Bekir111/access_control_hardware/README.md

# Access Control Hardware 

This repository contains the KiCad schematics and PCB designs for the Access Control System.
