Bekir111/access_control_hardware/access_control.kicad_pcb

## KiCad design access_control.kicad_pcb (2026-07-22)

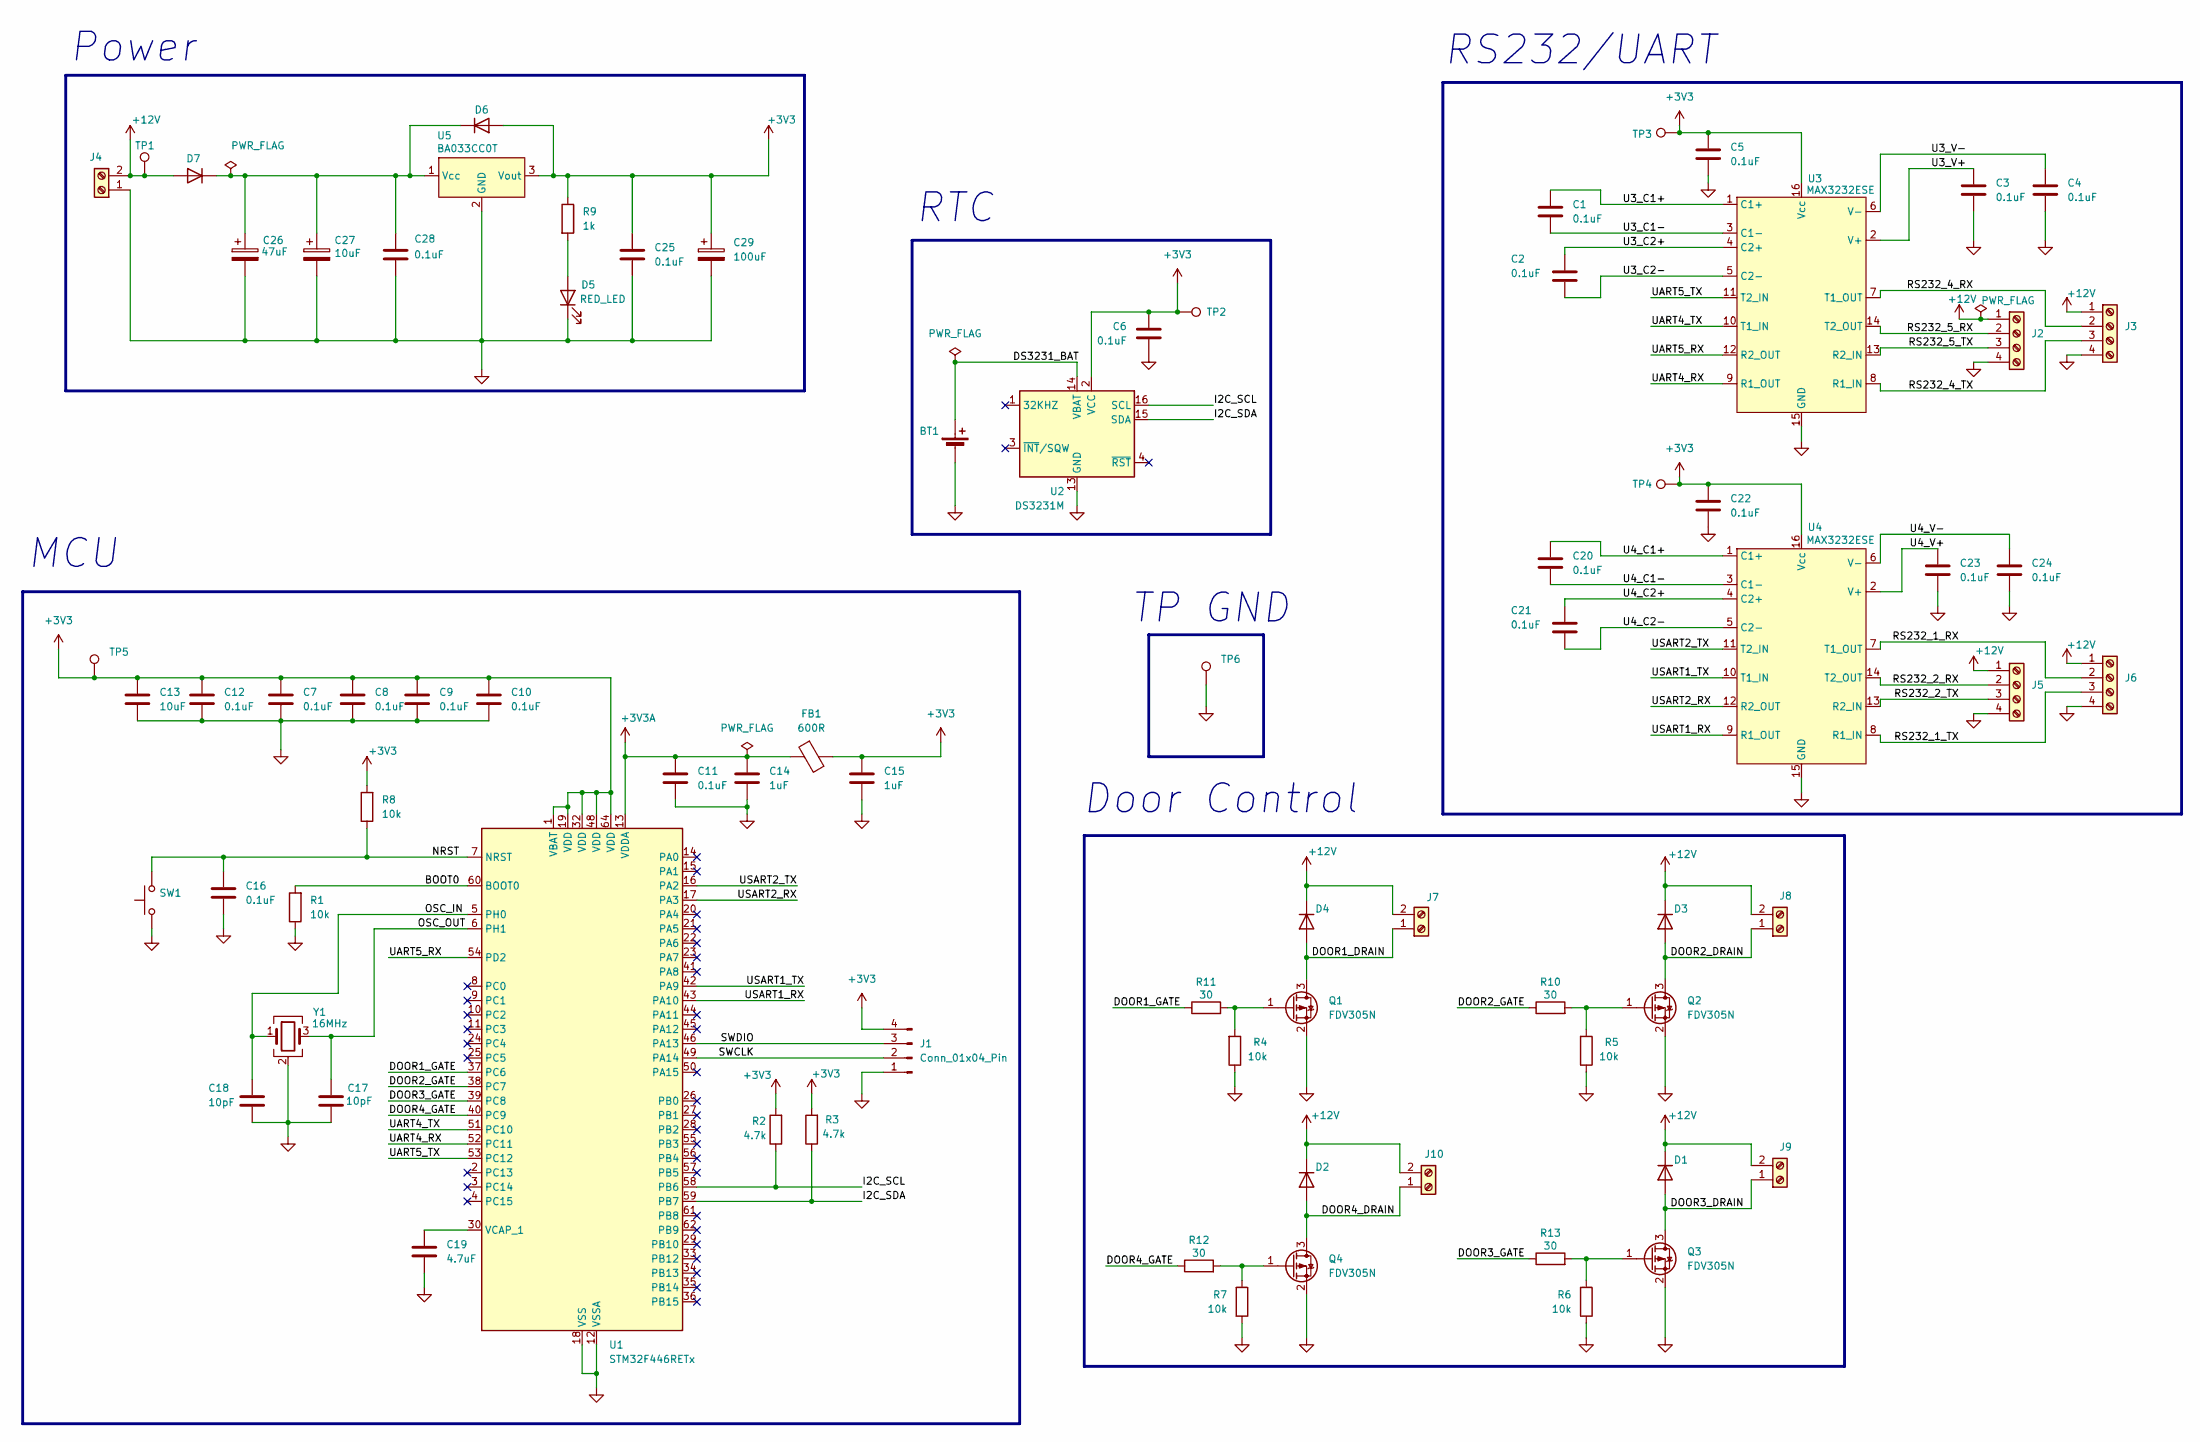
[picture p1: schematic access_control.kicad_sch]

Parts:
BT1: Battery_Cell; BatteryHolder_Keystone_1060_1x2032; LCSC C70377
C1, C2, C3, C4, C5, C6, C7, C8, C9, C10, C11, C12, C16, C20, C21, C22, C23, C24, C25, C28: 0.1uF; C_0805_2012Metric_Pad1.18x1.45mm_HandSolder; LCSC C1711
C13: 10uF; C_0805_2012Metric_Pad1.18x1.45mm_HandSolder; LCSC C15850
C14, C15: 1uF; C_0805_2012Metric_Pad1.18x1.45mm_HandSolder; LCSC C91185
C17, C18: 10pF; C_0805_2012Metric_Pad1.18x1.45mm_HandSolder; MPN CC0805JRNPO9BN100; LCSC C107107
C19: 4.7uF; C_0805_2012Metric_Pad1.18x1.45mm_HandSolder; MPN CL21A475KAQNNNE
C26: 47uF; CP_Radial_D6.3mm_P2.50mm; MPN EXR470M35B
C27: 10uF; CP_Radial_D5.0mm_P2.50mm; MPN RK1V100M-TSD11
C29: 100uF; CP_Radial_D6.3mm_P2.50mm; MPN RM1C101M-RBE07
D1, D2, D3, D4, D6, D7: D; D_SMA-SMB_Universal_Handsoldering; MPN M7; LCSC C2972759
D5: RED_LED; LED_D3.0mm
FB1: 600R; L_0805_2012Metric_Pad1.05x1.20mm_HandSolder; MPN BLM21BD601SN1D; LCSC C341663
J1: Conn_01x04_Pin; PinHeader_1x04_P2.54mm_Vertical
J2, J3, J5, J6: Screw_Terminal_01x04; TerminalBlock_Phoenix_MKDS-1,5-4-5.08_1x04_P5.08mm_Horizont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
J4, J7, J8, J9, J10: Screw_Terminal_01x02; TerminalBlock_Phoenix_MKDS-1,5-2-5.08_1x02_P5.08mm_Horizont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
Q1, Q2, Q3, Q4: FDV305N; SOT-23; MPN FDV305N; LCSC C154511
R1, R4, R5, R6, R7, R8: 10k; R_0805_2012Metric_Pad1.20x1.40mm_HandSolder; MPN RC0805FR-0710KL; LCSC C84376
R2, R3: 4.7k; R_0805_2012Metric_Pad1.20x1.40mm_HandSolder; MPN CRCW08054K70JNTABC; LCSC C2907326
R9: 1k; R_0805_2012Metric_Pad1.20x1.40mm_HandSolder; MPN RC0805FR-071KL; LCSC C2907295
R10, R11, R12, R13: 30; R_0805_2012Metric_Pad1.20x1.40mm_HandSolder; MPN CRCW080530R0FKTABC; LCSC C2907256
SW1: Reset button; SW_SPST_PTS645Sx43SMTR92; MPN TS110416043; LCSC C22375342
TP1, TP2, TP3, TP4, TP5, TP6: TestPoint; TestPoint_Pad_D2.0mm
U1: STM32F446RETx; LQFP-64_10x10mm_P0.5mm; MPN STM32F446RET6; LCSC C69336
U2: DS3231M; SOIC-16W_7.5x10.3mm_P1.27mm; MPN DS3231SN#T&R; LCSC C9866
U3, U4: MAX3232ESE; SOIC-16_3.9x9.9mm_P1.27mm; LCSC C143435
U5: BA033CC0T; TO-220-3_Horizontal_TabDown; MPN BA033CC0T; LCSC C184572
Y1: 16MHz; Crystal_SMD_3225-4Pin_3.2x2.5mm_HandSoldering; MPN X322516MKB4SI; LCSC C13738

Connections:
+3V3: C5.1, C6.1, C7.1, C8.1, C9.1, C10.1, C12.1, C13.1, C15.1, C22.1, C25.1, C29.1, D6.2 (A), FB1.2, J1.4, R2.2, R3.2, R8.2, R9.1, TP2.1, TP3.1, TP4.1, TP5.1, U1.1 (VBAT), U1.19 (VDD), U1.32 (VDD), U1.48 (VDD), U1.64 (VDD), U2.2 (VCC), U3.16 (Vcc), U4.16 (Vcc), U5.3 (Vout)
+3V3A: C11.1, C14.1, FB1.1, U1.13 (VDDA)
+12V: D1.1 (K), D2.1 (K), D3.1 (K), D4.1 (K), D7.2 (A), J2.1, J3.1, J4.2, J5.1, J6.1, J7.2, J8.2, J9.2, J10.2, TP1.1
/BOOT0: R1.2, U1.60 (BOOT0)
/DOOR1_DRAIN: D4.2 (A), J7.1, Q1.3 (D)
/DOOR1_GATE: R11.1, U1.37 (PC6)
/DOOR2_DRAIN: D3.2 (A), J8.1, Q2.3 (D)
/DOOR2_GATE: R10.1, U1.38 (PC7)
/DOOR3_DRAIN: D1.2 (A), J9.1, Q3.3 (D)
/DOOR3_GATE: R13.1, U1.39 (PC8)
/DOOR4_DRAIN: D2.2 (A), J10.1, Q4.3 (D)
/DOOR4_GATE: R12.1, U1.40 (PC9)
/DS3231_BAT: BT1.1 (+), U2.14 (VBAT)
/I2C_SCL: R2.1, U1.58 (PB6), U2.16 (SCL)
/I2C_SDA: R3.1, U1.59 (PB7), U2.15 (SDA)
/NRST: C16.1, R8.1, SW1.2, U1.7 (NRST)
/OSC_IN: C18.1, U1.5 (PH0), Y1.1
/OSC_OUT: C17.1, U1.6 (PH1), Y1.3
/RS232_1_RX: J6.2, U4.7 (T1_OUT)
/RS232_1_TX: J6.3, U4.8 (R1_IN)
/RS232_2_RX: J5.2, U4.14 (T2_OUT)
/RS232_2_TX: J5.3, U4.13 (R2_IN)
/RS232_4_RX: J3.2, U3.7 (T1_OUT)
/RS232_4_TX: J3.3, U3.8 (R1_IN)
/RS232_5_RX: J2.2, U3.14 (T2_OUT)
/RS232_5_TX: J2.3, U3.13 (R2_IN)
/SWCLK: J1.2, U1.49 (PA14)
/SWDIO: J1.3, U1.46 (PA13)
/U3_C1+: C1.1, U3.1 (C1+)
/U3_C1-: C1.2, U3.3 (C1-)
/U3_C2+: C2.1, U3.4 (C2+)
/U3_C2-: C2.2, U3.5 (C2-)
/U3_V+: C3.1, U3.2 (V+)
/U3_V-: C4.1, U3.6 (V-)
/U4_C1+: C20.1, U4.1 (C1+)
/U4_C1-: C20.2, U4.3 (C1-)
/U4_C2+: C21.1, U4.4 (C2+)
/U4_C2-: C21.2, U4.5 (C2-)
/U4_V+: C23.1, U4.2 (V+)
/U4_V-: C24.1, U4.6 (V-)
/UART4_RX: U1.52 (PC11), U3.9 (R1_OUT)
/UART4_TX: U1.51 (PC10), U3.10 (T1_IN)
/UART5_RX: U1.54 (PD2), U3.12 (R2_OUT)
/UART5_TX: U1.53 (PC12), U3.11 (T2_IN)
/USART1_RX: U1.43 (PA10), U4.9 (R1_OUT)
/USART1_TX: U1.42 (PA9), U4.10 (T1_IN)
/USART2_RX: U1.17 (PA3), U4.12 (R2_OUT)
/USART2_TX: U1.16 (PA2), U4.11 (T2_IN)
GND: BT1.2 (-), C3.2, C4.2, C5.2, C6.2, C7.2, C8.2, C9.2, C10.2, C11.2, C12.2, C13.2, C14.2, C15.2, C16.2, C17.2, C18.2, C19.2, C22.2, C23.2, C24.2, C25.2, C26.2, C27.2, C28.2, C29.2, D5.1 (K), J1.1, J2.4, J3.4, J4.1, J5.4, J6.4, Q1.2 (S), Q2.2 (S), Q3.2 (S), Q4.2 (S), R1.1, R4.1, R5.1, R6.1, R7.1, SW1.1, TP6.1, U1.12 (VSSA), U1.18 (VSS), U1.31 (VSS), U1.47 (VSS), U1.63 (VSS), U2.5 (GND), U2.6 (GND), U2.7 (GND), U2.8 (GND), U2.9 (GND), U2.10 (GND), U2.11 (GND), U2.12 (GND), U2.13 (GND), U3.15 (GND), U4.15 (GND), U5.2 (GND), Y1.2 (G), Y1.4 (G)
unnamed: D5.2 (A), R9.2
unnamed: C26.1, C27.1, C28.1, D6.1 (K), D7.1 (K), U5.1 (Vcc)
unnamed: Q1.1 (G), R4.2, R11.2
unnamed: Q2.1 (G), R5.2, R10.2
unnamed: Q3.1 (G), R6.2, R13.2
unnamed: Q4.1 (G), R7.2, R12.2
unnamed: C19.1, U1.30 (VCAP_1)

Notes on the sheet:
Door Control
TP GND
RS232/UART
MCU
RTC
Power

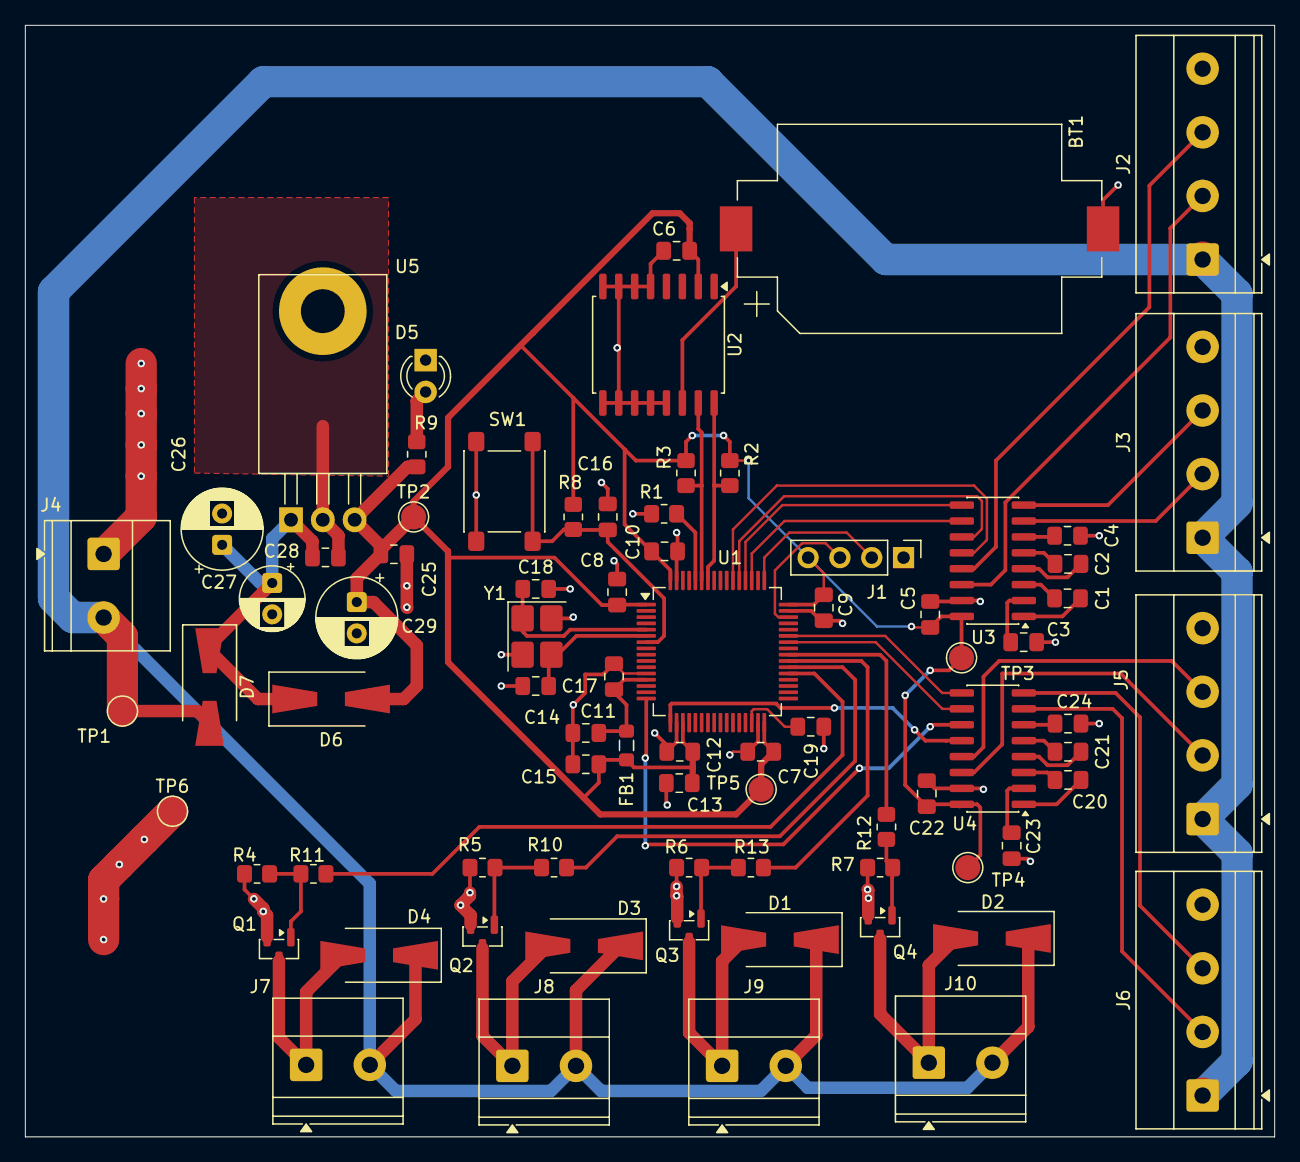
[picture p2: board access_control.kicad_pcb from above]

Board: 2 copper layers, 99.8 x 88.8 mm, 78 parts (0 on the bottom side), 56 nets.
