Bekir111/access_control_hardware/(commit log)

2026-05-07 Inital commit for hardware part of the Access Control diploma project
    [access_control.kicad_pcb, access_control.kicad_sch]
2026-05-15 Created schematic symbol for MAX3232ESE+ chip
2026-05-19 Drew the typical operating system for MAX3232 chip
    [access_control.kicad_sch]
2026-05-22 Drwe typical operating circuit for ds3231 and started with MCU's circuit
    [access_control.kicad_sch]
2026-05-24 Added decoupling capacitors for Vdd and Vdda. Drew HSE oscillator. BOOT0 connected to ground via 10k pull-down. Boot connected to ground via capacitor and swith for manual reset option.
    [access_control.kicad_sch]
2026-05-24 Added SWD connectors. Added 4.7u capacitor to VCAP_1. Changed all SMD footprints to HandSolder
    [access_control.kicad_sch]
2026-05-26 Connected DS3231 and MAX3232 to the MCU
    [access_control.kicad_sch]
2026-06-01 Created new symbol for the voltage regulator
2026-06-01 Connected the MOSFETS to the door control pins. Added footprints and info about the mosfets that i will use. Same information added for the voltage regulator
    [access_control.kicad_sch]
2026-06-01 Placed the needed capacitors around the BA033CC0T
    [access_control.kicad_sch]
2026-06-02 Added pull up resistor 10k to the NRST pin
    [access_control.kicad_sch]
2026-06-02 ERC check verified
    [access_control.kicad_sch]
2026-06-02 Assigned footprint and information about the diodes D1-4. Added functional block frames.
    [access_control.kicad_sch]
2026-06-03 Added LED indication for 3.3V
    [access_control.kicad_sch]
2026-06-04 Changed the oscillator with another one that is in stock
    [access_control.kicad_sch]
2026-06-04 Placed 30 Ohms resistors to every transistors gate
    [access_control.kicad_sch]
2026-06-04 Chnged the VCAP capacitor with another that is in stock
    [access_control.kicad_sch]
2026-06-11 Created BOM for the project
    [access_control_hardware_BOM.csv, access_control_hardware_BOM.xlsx]
2026-06-11 Component placement for the PCB is ready.
    [access_control.kicad_pcb, access_control.kicad_sch]
2026-06-14 Finished the PCB routing and placement of the components.
    [access_control.kicad_pcb, access_control.kicad_sch]
2026-06-17 Finilized editing PCB, generated BOM and grb files. PCB files are sent to JLCPCB
    [access_control-B_Cu.gbl, access_control-B_Mask.gbs, access_control-B_Paste.gbp, access_control-B_Silkscreen.gbo, access_control-Edge_Cuts.gm1, access_control-F_Cu.gtl, access_control-F_Mask.gts, access_control-F_Paste.gtp]
2026-07-22 PCB is ready
    [access_control.kicad_pcb]
